GeorgeTsakiridis/Tsakalarm/README.md

# Tsakalarm
Tsakalarm is an open source project which includes the construction of a bedside table alarm clock, the software it runs as well as an Android app for easily configuring it
