GeorgeTsakiridis/Tsakalarm/Clock.FCStd

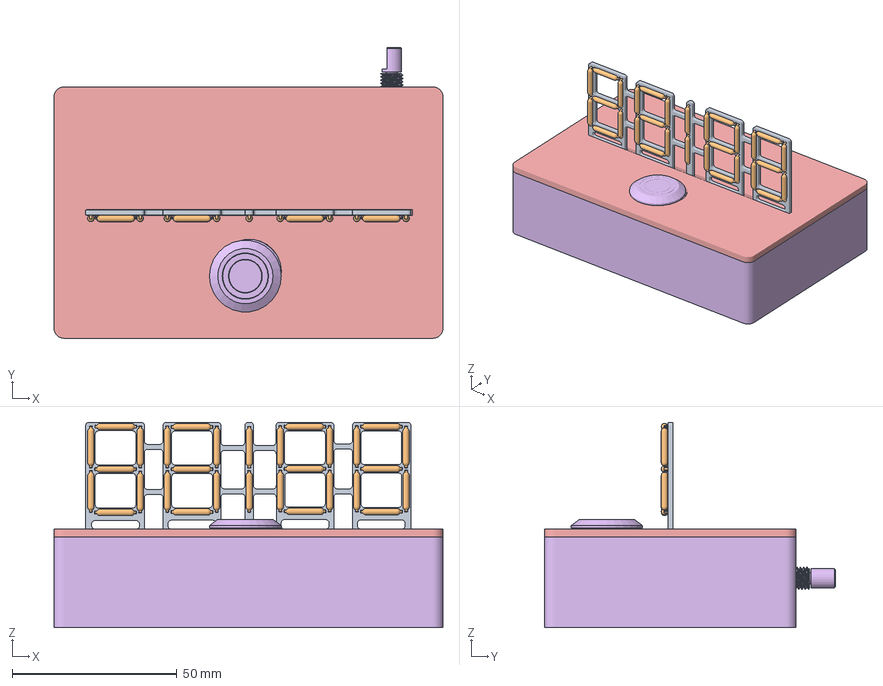
[picture p1: CAD file, 2025-12-01]
Clock.FCStd
118.0 x 88.1 x 62.3 mm
Pcb_2d36
C2_Body_729c8f8a6e54 x 30
J1_PinHeader_1x08_P200mm_Vertical_ca66132974ad x 4
J5_PinHeader_1x03_P200mm_Vertical_c6a56cade27a
Top
Bottom Case
USB C female wall mount Assy001
Buzzer 5v
ѽת±ძǷ
ѽת±ძǷ001
ѽת±ძǷ002
ѽת±ძǷ003
ѽת±ძǷ004
ѽת±ძǷ005
Pcb_4508
SOT-23-3P_L2.9-W1.3-H1.0-LS2.4-P0.95 x 31
SOT-23-3P_L2.9-W1.3-H1.0-LS2.4-P0.096 x 31
SOT-23-3P_L2.9-W1.3-H1.0-LS2.4-P0.097 x 31
SOT-23-3P_L2.9-W1.3-H1.0-LS2.4-P0.098 x 31
SOT-23-3P_L2.9-W1.3-H1.0-LS2.4-P0.099 x 31
SOT-23-3P_L2.9-W1.3-H1.0-LS2.4-P0.100 x 31
SOT-23-3P_L2.9-W1.3-H1.0-LS2.4-P0.101 x 31
SOT-23-3P_L2.9-W1.3-H1.0-LS2.4-P0.102 x 31
SOT-23-3P_L2.9-W1.3-H1.0-LS2.4-P0.103 x 31
SOT-23-3P_L2.9-W1.3-H1.0-LS2.4-P0.104 x 31
SOT-23-3P_L2.9-W1.3-H1.0-LS2.4-P0.105 x 31
SOT-23-3P_L2.9-W1.3-H1.0-LS2.4-P0.106 x 31
SOT-23-3P_L2.9-W1.3-H1.0-LS2.4-P0.107 x 31
SOT-23-3P_L2.9-W1.3-H1.0-LS2.4-P0.108 x 31
SOT-23-3P_L2.9-W1.3-H1.0-LS2.4-P0.109 x 31
SOT-23-3P_L2.9-W1.3-H1.0-LS2.4-P0.110 x 31
SOT-23-3P_L2.9-W1.3-H1.0-LS2.4-P0.111 x 31
R18_R_0805_2012Metric_81b06d692103 x 73
D4B1_PinHeader_1x01_P254mm_Vertical_329921953e49 x 37
D1_LL-34_L3.5-W1.5_c85fa7ff838f
SOIC-16_L9.9-W3.9-H1.8-LS6.0-P1.27 x 4
SOIC-16_L9.9-W3.9-H1.8-LS6.0-P1.028 x 4
SOIC-16_L9.9-W3.9-H1.8-LS6.0-P1.029 x 4
SOIC-16_L9.9-W3.9-H1.8-LS6.0-P1.030 x 4
SOIC-16_L9.9-W3.9-H1.8-LS6.0-P1.031 x 4
SOIC-16_L9.9-W3.9-H1.8-LS6.0-P1.032 x 4
SOIC-16_L9.9-W3.9-H1.8-LS6.0-P1.033 x 4
SOIC-16_L9.9-W3.9-H1.8-LS6.0-P1.034 x 4
SOIC-16_L9.9-W3.9-H1.8-LS6.0-P1.035 x 4
SOIC-16_L9.9-W3.9-H1.8-LS6.0-P1.036 x 4
SOIC-16_L9.9-W3.9-H1.8-LS6.0-P1.037 x 4
SOIC-16_L9.9-W3.9-H1.8-LS6.0-P1.038 x 4
SOIC-16_L9.9-W3.9-H1.8-LS6.0-P1.039 x 4
SOIC-16_L9.9-W3.9-H1.8-LS6.0-P1.040 x 4
SOIC-16_L9.9-W3.9-H1.8-LS6.0-P1.041 x 4
SOIC-16_L9.9-W3.9-H1.8-LS6.0-P1.042 x 4
SOIC-16_L9.9-W3.9-H1.8-LS6.0-P1.043 x 4
SOIC-16_L9.9-W3.9-H1.8-LS6.0-P1.044 x 4
SOIC-16_L9.9-W3.9-H1.8-LS6.0-P1.045 x 4
SOIC-16_L9.9-W3.9-H1.8-LS6.0-P1.046 x 4
SOIC-16_L9.9-W3.9-H1.8-LS6.0-P1.047 x 4
SOIC-16_L9.9-W3.9-H1.8-LS6.0-P1.048 x 4
SOIC-16_L9.9-W3.9-H1.8-LS6.0-P1.049 x 4
SOIC-16_L9.9-W3.9-H1.8-LS6.0-P1.050 x 4
SOIC-16_L9.9-W3.9-H1.8-LS6.0-P1.051 x 4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
