GeorgeTsakiridis/Tsakalarm/DIY Clock/DIY Clock.kicad_pcb

## KiCad design DIY Clock/DIY Clock.kicad_pcb (2025-12-01)

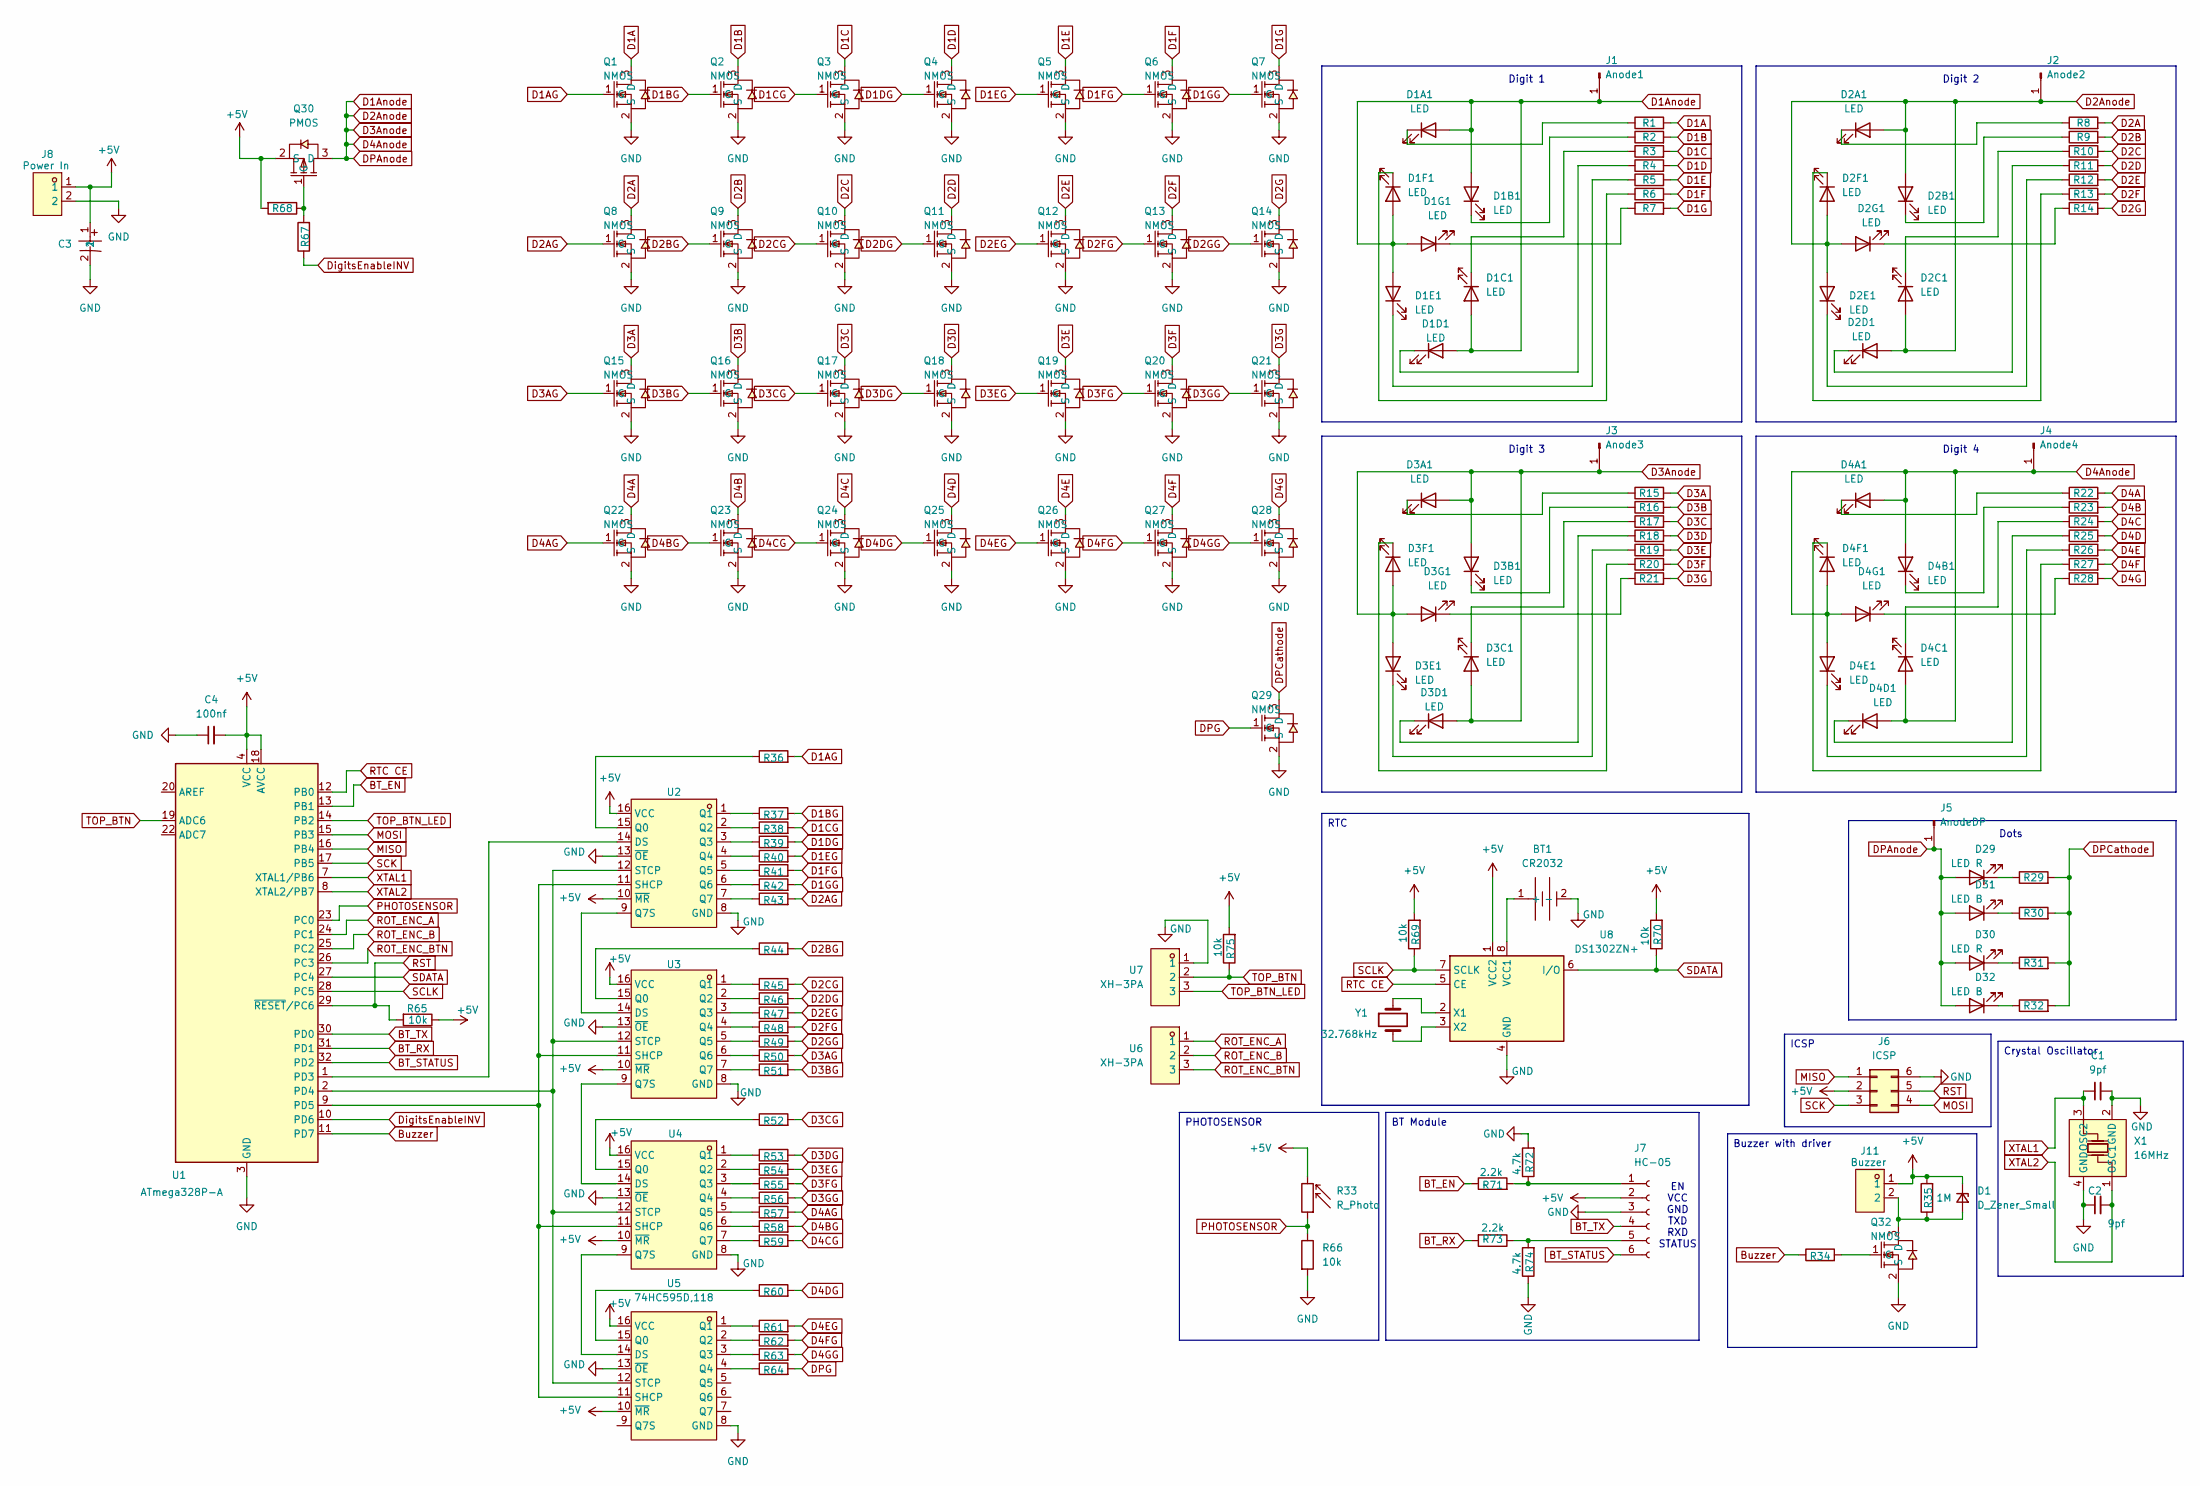
[picture p2: schematic DIY Clock.kicad_sch]

Parts:
BT1: CR2032; BAT-TH_120591-1; LCSC Part C575181
C1, C2: 9pf; C_0805_2012Metric_Pad1.18x1.45mm_HandSolder
C3: 35PX1000MEFC10X20; CAP-TH_BD10.0-P5.00-D1.0-FD; LCSC Part C136014
C4: 100nf; C_0805_2012Metric_Pad1.18x1.45mm_HandSolder
D1: D_Zener_Small; LL-34_L3.5-W1.5-RD
D1A1, D1B1, D1C1, D1D1, D1E1, D1F1, D1G1, D2A1, D2B1, D2C1, D2D1, D2E1, D2F1, D2G1, D3A1, D3B1, D3C1, D3D1, D3E1, D3F1, D3G1, D4A1, D4B1, D4C1, D4D1, D4E1, D4F1, D4G1: LED; PinHeader_1x01_P2.54mm_Vertical
D29, D30: LED R; PinHeader_1x01_P2.54mm_Vertical
D31, D32: LED B; PinHeader_1x01_P2.54mm_Vertical
J1: Anode1; PinHeader_1x01_P2.54mm_Vertical
J2: Anode2; PinHeader_1x01_P2.54mm_Vertical
J3: Anode3; PinHeader_1x01_P2.54mm_Vertical
J4: Anode4; PinHeader_1x01_P2.54mm_Vertical
J5: AnodeDP; PinHeader_1x01_P2.54mm_Vertical
J6: ICSP; PinHeader_2x03_P2.54mm_Vertical
J7: HC-05; PinHeader_1x06_P2.54mm_Vertical
J8: Power In; CONN-TH_XH-2A; LCSC Part C5258883
J11: Buzzer; PinHeader_1x02_P2.54mm_Vertical; LCSC Part C5258883
Q1, Q2, Q3, Q4, Q5, Q6, Q7, Q8, Q9, Q10, Q11, Q12, Q13, Q14, Q15, Q16, Q17, Q18, Q19, Q20, Q21, Q22, Q23, Q24, Q25, Q26, Q27, Q28, Q29, Q32: NMOS; SOT-23-3_L2.9-W1.3-P1.90-LS2.4-BR; LCSC Part C347475
Q30: PMOS; SOT-23_L2.9-W1.3-P1.90-LS2.4-BR; LCSC Part C347476
R1, R2, R3, R4, R5, R6, R7, R8, R9, R10, R11, R12, R13, R14, R15, R16, R17, R18, R19, R20, R21, R22, R23, R24, R25, R26, R27, R28, R29, R30, R31, R32: R; R_0805_2012Metric_Pad1.20x1.40mm_HandSolder
R33: R_Photo; PinHeader_1x02_P2.54mm_Vertical
R34, R36, R37, R38, R39, R40, R41, R42, R43, R44, R45, R46, R47, R48, R49, R50, R51, R52, R53, R54, R55, R56, R57, R58, R59, R60, R61, R62, R63, R64, R67: 1k; R_0805_2012Metric_Pad1.20x1.40mm_HandSolder
R35: 1M; R_0805_2012Metric_Pad1.20x1.40mm_HandSolder
R65, R66, R68, R69, R70, R75: 10k; R_0805_2012Metric_Pad1.20x1.40mm_HandSolder
R71, R73: 2.2k; R_0805_2012Metric_Pad1.20x1.40mm_HandSolder
R72, R74: 4.7k; R_0805_2012Metric_Pad1.20x1.40mm_HandSolder
U1: ATmega328P-A; TQFP-32_7x7mm_P0.8mm
U2, U3, U4, U5: 74HC595D,118; SOIC-16_L9.9-W3.9-P1.27-LS6.0-BL; LCSC Part C5947
U6, U7: XH-3PA; CONN-TH_3P-P2.50_ZHOURI_XH-3PA; LCSC Part C5258884
U8: DS1302ZN+; SOIC-8_3.9x4.9mm_P1.27mm
X1: 16MHz; CRYSTAL-SMD_4P-L3.2-W2.5-BL; LCSC Part C390767
Y1: 32.768kHz; Crystal_DS26_D2.0mm_L6.0mm_Horizontal

Connections:
+5V: C3.1, C4.2, D1.1 (K), J6.2, J7.2, J8.1, J11.1, Q30.2 (S), R33.2, R35.2, R65.1, R68.2, R69.2, R70.2, R75.2, U1.4 (VCC), U1.6 (VCC), U1.18 (AVCC), U2.10 (~MR), U2.16 (VCC), U3.10 (~MR), U3.16 (VCC), U4.10 (~MR), U4.16 (VCC), U5.10 (~MR), U5.16 (VCC), U8.1 (VCC2)
BT_EN: R71.1, U1.13 (PB1)
BT_RX: R73.2, U1.31 (PD1)
BT_STATUS: J7.6, U1.32 (PD2)
BT_TX: J7.4, U1.30 (PD0)
Buzzer: R34.1, U1.11 (PD7)
D1A: Q1.3 (D), R1.2
D1AG: Q1.1 (G), R36.2
D1Anode: D1A1.2 (A), D1B1.2 (A), D1C1.2 (A), D1D1.2 (A), D1E1.2 (A), D1F1.2 (A), D1G1.2 (A), D2A1.2 (A), D2B1.2 (A), D2C1.2 (A), D2D1.2 (A), D2E1.2 (A), D2F1.2 (A), D2G1.2 (A), D3A1.2 (A), D3B1.2 (A), D3C1.2 (A), D3D1.2 (A), D3E1.2 (A), D3F1.2 (A), D3G1.2 (A), D4A1.2 (A), D4B1.2 (A), D4C1.2 (A), D4D1.2 (A), D4E1.2 (A), D4F1.2 (A), D4G1.2 (A), D29.2 (A), D30.2 (A), D31.2 (A), D32.2 (A), J1.1, J2.1, J3.1, J4.1, J5.1, Q30.3 (D)
D1B: Q2.3 (D), R2.2
D1BG: Q2.1 (G), R37.2
D1C: Q3.3 (D), R3.2
D1CG: Q3.1 (G), R38.2
D1D: Q4.3 (D), R4.2
D1DG: Q4.1 (G), R39.2
D1E: Q5.3 (D), R5.2
D1EG: Q5.1 (G), R40.2
D1F: Q6.3 (D), R6.2
D1FG: Q6.1 (G), R41.2
D1G: Q7.3 (D), R7.2
D1GG: Q7.1 (G), R42.2
D2A: Q8.3 (D), R8.2
D2AG: Q8.1 (G), R43.2
D2B: Q9.3 (D), R9.2
D2BG: Q9.1 (G), R44.2
D2C: Q10.3 (D), R10.2
D2CG: Q10.1 (G), R45.2
D2D: Q11.3 (D), R11.2
D2DG: Q11.1 (G), R46.2
D2E: Q12.3 (D), R12.2
D2EG: Q12.1 (G), R47.2
D2F: Q13.3 (D), R13.2
D2FG: Q13.1 (G), R48.2
D2G: Q14.3 (D), R14.2
D2GG: Q14.1 (G), R49.2
D3A: Q15.3 (D), R15.2
D3AG: Q15.1 (G), R50.2
D3B: Q16.3 (D), R16.2
D3BG: Q16.1 (G), R51.2
D3C: Q17.3 (D), R17.2
D3CG: Q17.1 (G), R52.2
D3D: Q18.3 (D), R18.2
D3DG: Q18.1 (G), R53.2
D3E: Q19.3 (D), R19.2
D3EG: Q19.1 (G), R54.2
D3F: Q20.3 (D), R20.2
D3FG: Q20.1 (G), R55.2
D3G: Q21.3 (D), R21.2
D3GG: Q21.1 (G), R56.2
D4A: Q22.3 (D), R22.2
D4AG: Q22.1 (G), R57.2
D4B: Q23.3 (D), R23.2
D4BG: Q23.1 (G), R58.2
D4C: Q24.3 (D), R24.2
D4CG: Q24.1 (G), R59.2
D4D: Q25.3 (D), R25.2
D4DG: Q25.1 (G), R60.2
D4E: Q26.3 (D), R26.2
D4EG: Q26.1 (G), R61.2
D4F: Q27.3 (D), R27.2
D4FG: Q27.1 (G), R62.2
D4G: Q28.3 (D), R28.2
D4GG: Q28.1 (G), R63.2
DPCathode: Q29.3 (D), R29.2, R30.2, R31.2, R32.2
DPG: Q29.1 (G), R64.2
DigitsEnableINV: R67.1, U1.10 (PD6)
GND: BT1.2 (-), C1.2, C2.1, C3.2, C4.1, J6.6, J7.3, J8.2, Q1.2 (S), Q2.2 (S), Q3.2 (S), Q4.2 (S), Q5.2 (S), Q6.2 (S), Q7.2 (S), Q8.2 (S), Q9.2 (S), Q10.2 (S), Q11.2 (S), Q12.2 (S), Q13.2 (S), Q14.2 (S), Q15.2 (S), Q16.2 (S), Q17.2 (S), Q18.2 (S), Q19.2 (S), Q20.2 (S), Q21.2 (S), Q22.2 (S), Q23.2 (S), Q24.2 (S), Q25.2 (S), Q26.2 (S), Q27.2 (S), Q28.2 (S), Q29.2 (S), Q32.2 (S), R66.2, R72.2, R74.1, U1.3 (GND), U1.5 (GND), U1.21 (GND), U2.8 (GND), U2.13 (~OE), U3.8 (GND), U3.13 (~OE), U4.8 (GND), U4.13 (~OE), U5.8 (GND), U5.13 (~OE), U7.1, U8.4 (GND), X1.2 (GND), X1.4 (GND)
MISO: J6.1, U1.16 (PB4)
MOSI: J6.4, U1.15 (PB3)
unnamed: BT1.1 (+), U8.8 (VCC1)
unnamed: D1.2 (A), J11.2, Q32.3 (D), R35.1
unnamed: D1A1.1 (K), R1.1
unnamed: D1B1.1 (K), R2.1
unnamed: D1C1.1 (K), R3.1
unnamed: D1D1.1 (K), R4.1
unnamed: D1E1.1 (K), R5.1
unnamed: D1F1.1 (K), R6.1
unnamed: D1G1.1 (K), R7.1
unnamed: D2A1.1 (K), R8.1
unnamed: D2B1.1 (K), R9.1
unnamed: D2C1.1 (K), R10.1
unnamed: D2D1.1 (K), R11.1
unnamed: D2E1.1 (K), R12.1
unnamed: D2F1.1 (K), R13.1
unnamed: D2G1.1 (K), R14.1
unnamed: D3A1.1 (K), R15.1
unnamed: D3B1.1 (K), R16.1
unnamed: D3C1.1 (K), R17.1
unnamed: D3D1.1 (K), R18.1
unnamed: D3E1.1 (K), R19.1
unnamed: D3F1.1 (K), R20.1
unnamed: D3G1.1 (K), R21.1
unnamed: D4A1.1 (K), R22.1
unnamed: D4B1.1 (K), R23.1
unnamed: D4C1.1 (K), R24.1
unnamed: D4D1.1 (K), R25.1
unnamed: D4E1.1 (K), R26.1
unnamed: D4F1.1 (K), R27.1
unnamed: D4G1.1 (K), R28.1
unnamed: D29.1 (K), R29.1
unnamed: D30.1 (K), R31.1
unnamed: D31.1 (K), R30.1
unnamed: D32.1 (K), R32.1
unnamed: J7.1, R71.2, R72.1
unnamed: J7.5, R73.1, R74.2
unnamed: Q30.1 (G), R67.2, R68.1
unnamed: Q32.1 (G), R34.2
unnamed: U1.1 (PD3), U2.14 (DS)
unnamed: U1.2 (PD4), U2.12 (STCP), U3.12 (STCP), U4.12 (STCP), U5.12 (STCP)
unnamed: U1.9 (PD5), U2.11 (SHCP), U3.11 (SHCP), U4.11 (SHCP), U5.11 (SHCP)
unnamed: R36.1, U2.15 (Q0)
unnamed: R37.1, U2.1 (Q1)
unnamed: R38.1, U2.2 (Q2)
unnamed: R39.1, U2.3 (Q3)
unnamed: R40.1, U2.4 (Q4)
unnamed: R41.1, U2.5 (Q5)
unnamed: R42.1, U2.6 (Q6)
unnamed: R43.1, U2.7 (Q7)
unnamed: U2.9 (Q7S), U3.14 (DS)
unnamed: R44.1, U3.15 (Q0)
unnamed: R45.1, U3.1 (Q1)
unnamed: R46.1, U3.2 (Q2)
unnamed: R47.1, U3.3 (Q3)
unnamed: R48.1, U3.4 (Q4)
unnamed: R49.1, U3.5 (Q5)
unnamed: R50.1, U3.6 (Q6)
unnamed: R51.1, U3.7 (Q7)
unnamed: U3.9 (Q7S), U4.14 (DS)
unnamed: R52.1, U4.15 (Q0)
unnamed: R53.1, U4.1 (Q1)
unnamed: R54.1, U4.2 (Q2)
unnamed: R55.1, U4.3 (Q3)
unnamed: R56.1, U4.4 (Q4)
unnamed: R57.1, U4.5 (Q5)
unnamed: R58.1, U4.6 (Q6)
unnamed: R59.1, U4.7 (Q7)
unnamed: U4.9 (Q7S), U5.14 (DS)
unnamed: R60.1, U5.15 (Q0)
unnamed: R61.1, U5.1 (Q1)
unnamed: R62.1, U5.2 (Q2)
unnamed: R63.1, U5.3 (Q3)
unnamed: R64.1, U5.4 (Q4)
unnamed: U8.2 (X1), Y1.1
unnamed: U8.3 (X2), Y1.2
PHOTOSENSOR: R33.1, R66.1, U1.23 (PC0)
ROT_ENC_A: U1.24 (PC1), U6.1
ROT_ENC_B: U1.25 (PC2), U6.2
ROT_ENC_BTN: U1.26 (PC3), U6.3
RST: J6.5, R65.2, U1.29 (~RESET/PC6)
RTC CE: U1.12 (PB0), U8.5 (CE)
SCK: J6.3, U1.17 (PB5)
SCLK: R69.1, U1.28 (PC5), U8.7 (SCLK)
SDATA: R70.1, U1.27 (PC4), U8.6 (I/O)
TOP_BTN: R75.1, U1.19 (ADC6), U7.2
TOP_BTN_LED: U1.14 (PB2), U7.3
XTAL1: C1.1, U1.7 (XTAL1/PB6), X1.3 (OSC2)
XTAL2: C2.2, U1.8 (XTAL2/PB7), X1.1 (OSC1)

Notes on the sheet:
EN VCC GND TXD RXD STATUS
Dots
Digit 1
Digit 3
Digit 4
Digit 2
RTC
ICSP
BT Module
Crystal Oscillator
Buzzer with driver
PHOTOSENSOR

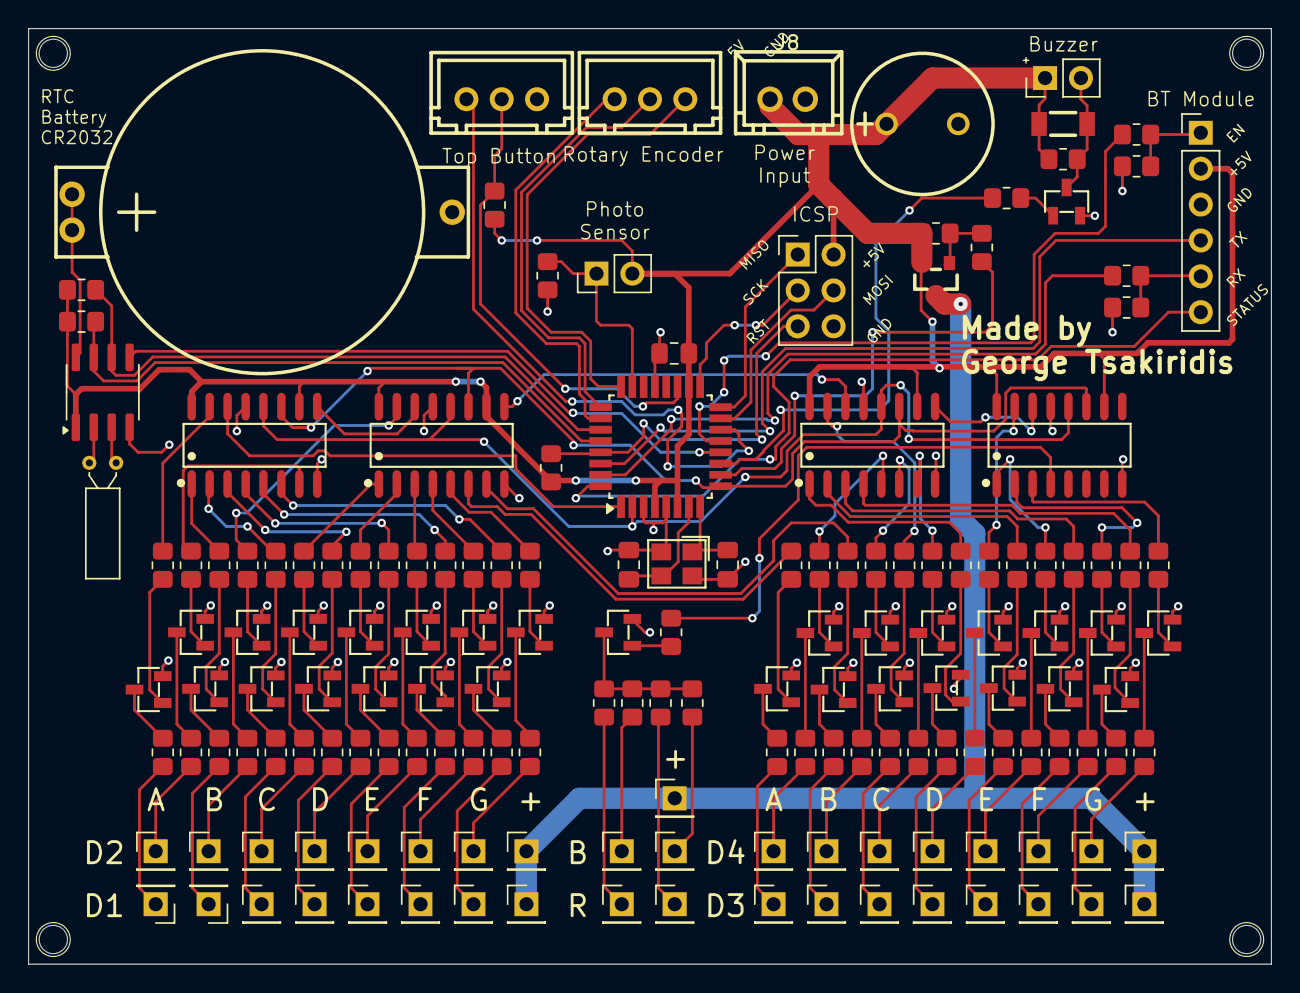
[picture p3: board DIY Clock.kicad_pcb from above]

Board: 2 copper layers, 88.0 x 66.2 mm, 163 parts (0 on the bottom side), 157 nets.
