GeorgeTsakiridis/Tsakalarm/DIY Clock LEDs Holder/DIY Clock LEDs Holder.kicad_pcb

## KiCad design DIY Clock LEDs Holder/DIY Clock LEDs Holder.kicad_pcb (2025-12-01)

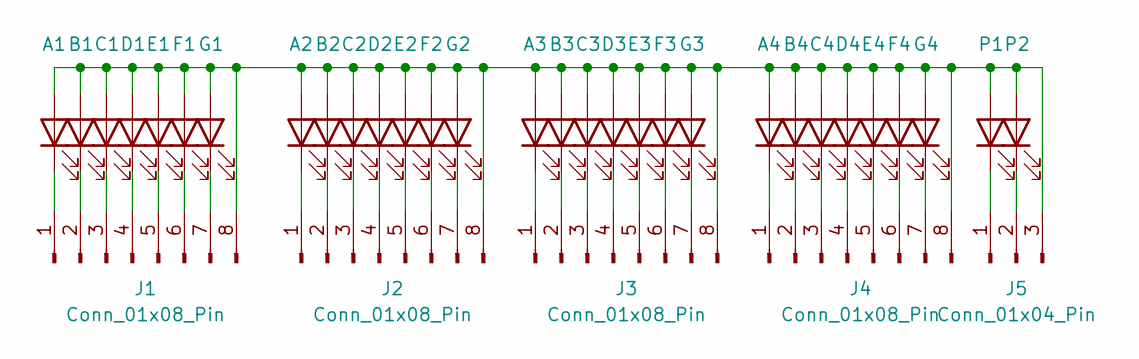
[picture p4: schematic DIY Clock LEDs Holder.kicad_sch]

Parts:
A1, A2, A3, A4: LED; LED Filament 12.3mm
B1, B2, B3, B4: LED; LED Filament 12.3mm
C1, C2, C3, C4: LED; LED Filament 12.3mm
D1, D2, D3, D4: LED; LED Filament 12.3mm
E1, E2, E3, E4: LED; LED Filament 12.3mm
F1, F2, F3, F4: LED; LED Filament 12.3mm
G1, G2, G3, G4: LED; LED Filament 12.3mm
J1, J2, J3, J4: Conn_01x08_Pin; PinHeader_1x08_P2.00mm_Vertical
J5: Conn_01x04_Pin; PinHeader_1x03_P2.00mm_Vertical
P1, P2: LED; LED Filament 12.3mm

Connections:
unnamed: A1.2 (A), A2.2 (A), A3.2 (A), A4.2 (A), B1.2 (A), B2.2 (A), B3.2 (A), B4.2 (A), C1.2 (A), C2.2 (A), C3.2 (A), C4.2 (A), D1.2 (A), D2.2 (A), D3.2 (A), D4.2 (A), E1.2 (A), E2.2 (A), E3.2 (A), E4.2 (A), F1.2 (A), F2.2 (A), F3.2 (A), F4.2 (A), G1.2 (A), G2.2 (A), G3.2 (A), G4.2 (A), J1.8, J2.8, J3.8, J4.8, J5.3, P1.2 (A), P2.2 (A)
unnamed: A1.1 (K), J1.1
unnamed: A2.1 (K), J2.1
unnamed: A3.1 (K), J3.1
unnamed: A4.1 (K), J4.1
unnamed: B1.1 (K), J1.2
unnamed: B2.1 (K), J2.2
unnamed: B3.1 (K), J3.2
unnamed: B4.1 (K), J4.2
unnamed: C1.1 (K), J1.3
unnamed: C2.1 (K), J2.3
unnamed: C3.1 (K), J3.3
unnamed: C4.1 (K), J4.3
unnamed: D1.1 (K), J1.4
unnamed: D2.1 (K), J2.4
unnamed: D3.1 (K), J3.4
unnamed: D4.1 (K), J4.4
unnamed: E1.1 (K), J1.5
unnamed: E2.1 (K), J2.5
unnamed: E3.1 (K), J3.5
unnamed: E4.1 (K), J4.5
unnamed: F1.1 (K), J1.6
unnamed: F2.1 (K), J2.6
unnamed: F3.1 (K), J3.6
unnamed: F4.1 (K), J4.6
unnamed: G1.1 (K), J1.7
unnamed: G2.1 (K), J2.7
unnamed: G3.1 (K), J3.7
unnamed: G4.1 (K), J4.7
unnamed: J5.1, P1.1 (K)
unnamed: J5.2, P2.1 (K)

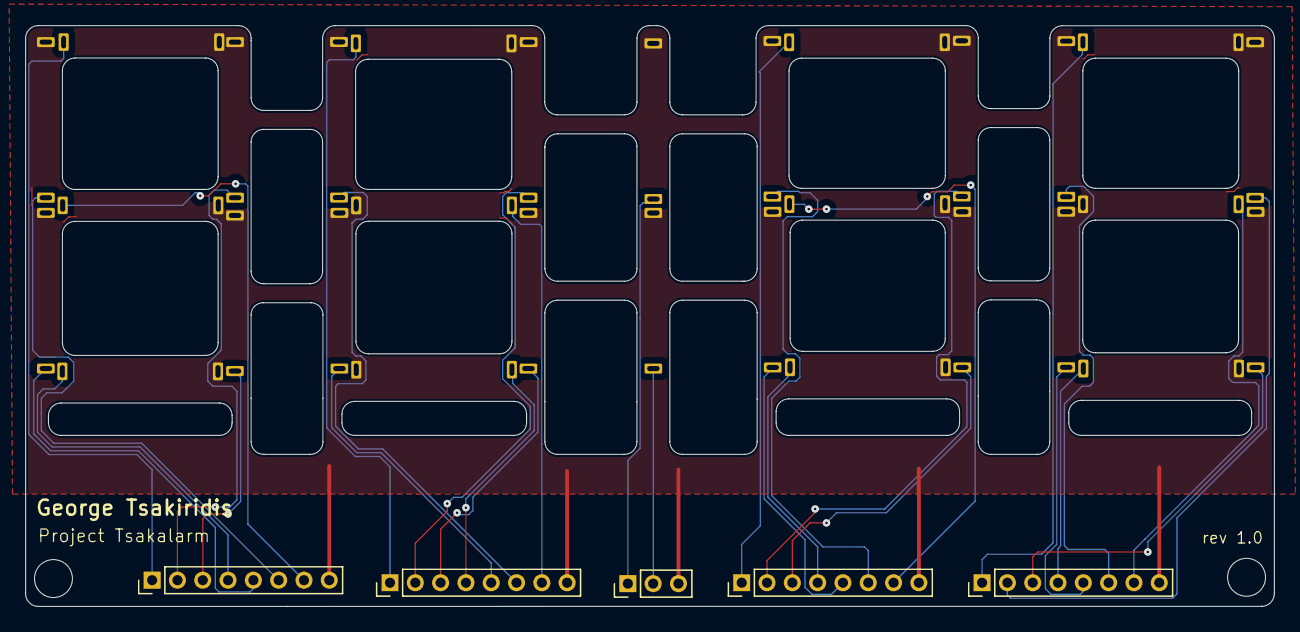
[picture p5: board DIY Clock LEDs Holder.kicad_pcb from above]

Board: 2 copper layers, 98.7 x 45.9 mm, 35 parts (0 on the bottom side), 31 nets.
