GeorgeTsakiridis/Tsakalarm/Tsakalarm/src/control/pins.hpp

#ifndef alarm_pins_h
#define alarm_pins_h

#define BT_TX_PIN 0
#define BT_RX_PIN 1
#define BT_STATUS_PIN 2
#define BT_ENABLE_PIN 9

#define SR_DATA_PIN 3
#define SR_ST_CLK_PIN 4
#define SR_OUT_CLK_PIN 5
#define DIGITS_ENABLE_PIN 6

#define RTC_ENABLE_PIN 8
#define RTC_DATA_PIN 18
#define RTC_CLK_PIN 19

#define ROT_ENC_A A1
#define ROT_ENC_B A2
#define ROT_ENC_BTN A3

#define TOP_BTN A6
#define TOP_BTN_LED 10

#define BUZZER_PIN 7
#define PHOTORESISTOR_PIN A0

#endif
